clem2k/SonicArt/Layers/arts/Access1.jpg

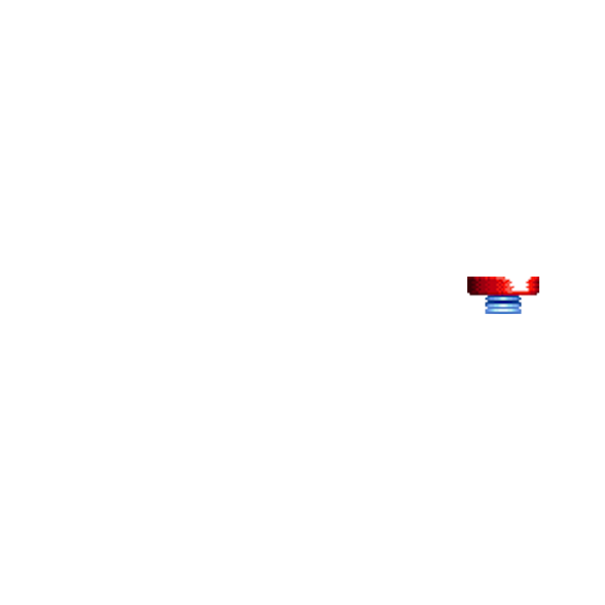
Layers/arts/Access1.jpg
