clem2k/SonicArt/Layers/arts/Access2.jpg

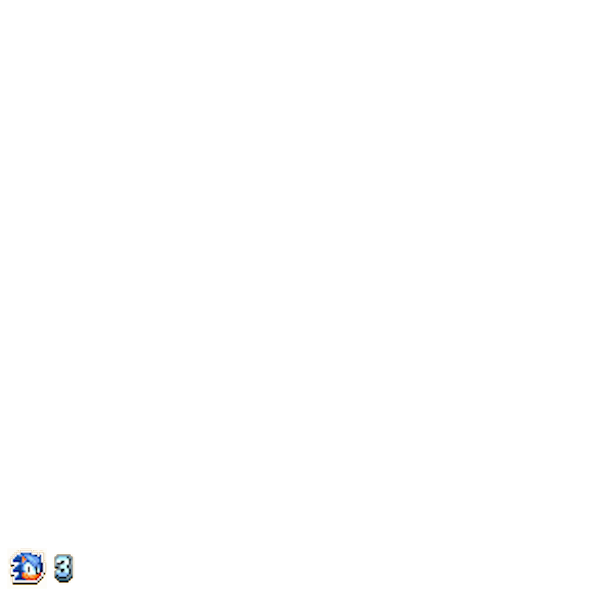
Layers/arts/Access2.jpg
