clem2k/SonicArt/Layers/arts/Rings.jpg

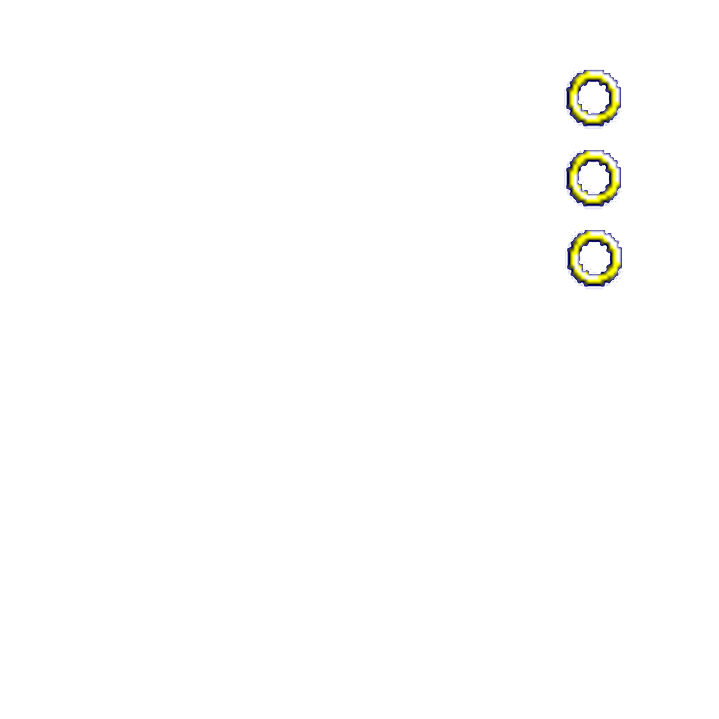
Layers/arts/Rings.jpg
