clem2k/SonicArt/Layers/arts/Sonic.jpg

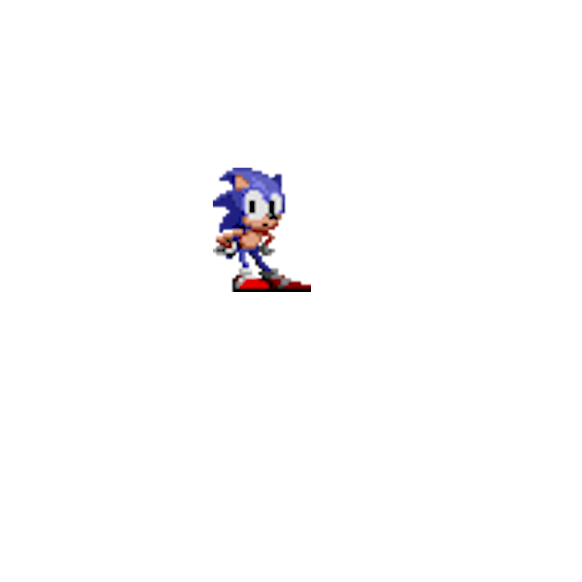
Layers/arts/Sonic.jpg
