clem2k/SonicArt/(commit log)

2021-09-18 arduino code
2021-09-26 decalage leds
2021-09-26 anim04 leds
2021-10-08 pin error
2021-10-10 update led count
